kimjinhwa/PoscoYardT53Sensor/(list of files, drawings)

Other design files:
doc/T52_AMPARE_V1(수정).DSN
doc/t52_ampare_v1(수정).opj
doc/T52_BAT_V1_1.DSN
doc/t52_bat_v1_1.opj
