kimjinhwa/PoscoYardT53Sensor/(commit log)

2025-07-16 Add Modbus Balance Target Voltage
2025-07-22 밸런싱 기능 추가
2025-07-22 Bluetooth 출력 기능 추가
2025-07-23 taget voltage 이상인 셀의 밸런싱 기능을 넣는다.
2025-07-24 가장높은 온도센서 2개만 서버에 올려준다>
2025-08-05 multicasting 부분 변경
